MustafaSeyhan/STM32F103-DENEY-KARTI/program kurulum linki.txt

proteus 8.13 program kurulum linki:

https://drive.google.com/drive/folders/1x-LD3BekIUSsy72zg72kJlgUW_x6A9uk?usp=sharing
