MustafaSeyhan/STM32F103-DENEY-KARTI/STM32F103_DENEME_KARTI_2025-2026_2_ŞEMA.png

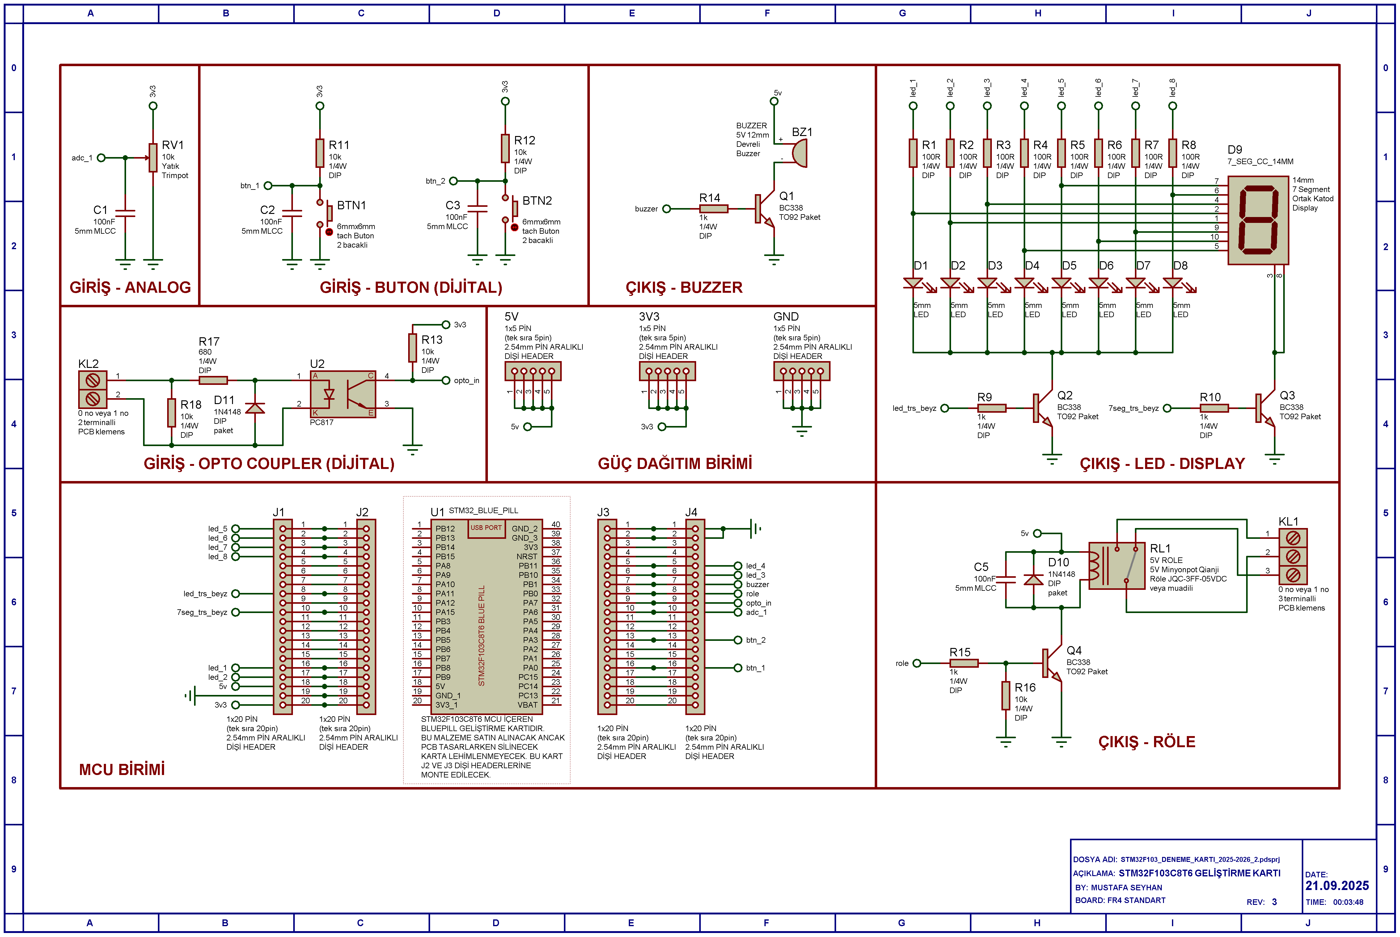
STM32F103_DENEME_KARTI_2025-2026_2_ŞEMA.png
