MustafaSeyhan/STM32F103-DENEY-KARTI/Veri Toplama ve dokümanlar/61TfQhFysAL._AC_SL1200_.jpg

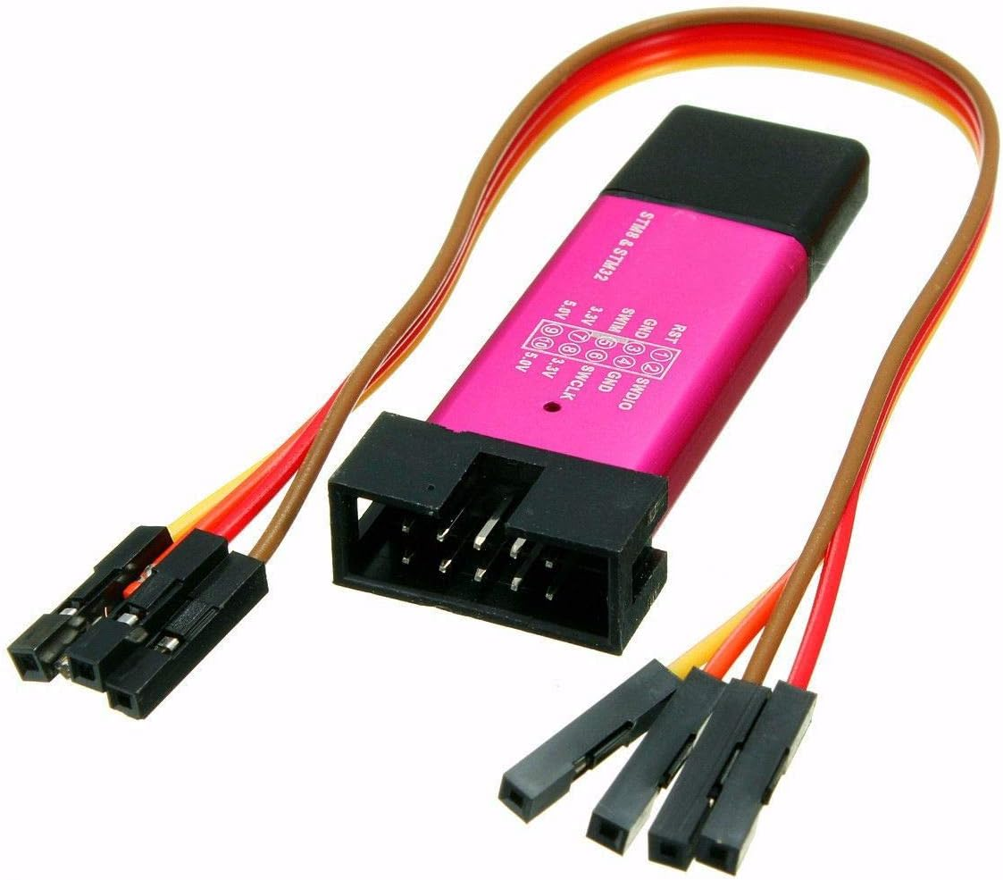
Veri Toplama ve dokümanlar/61TfQhFysAL._AC_SL1200_.jpg
