MustafaSeyhan/STM32F103-DENEY-KARTI/Veri Toplama ve dokümanlar/klon stlink v2 - 2.png

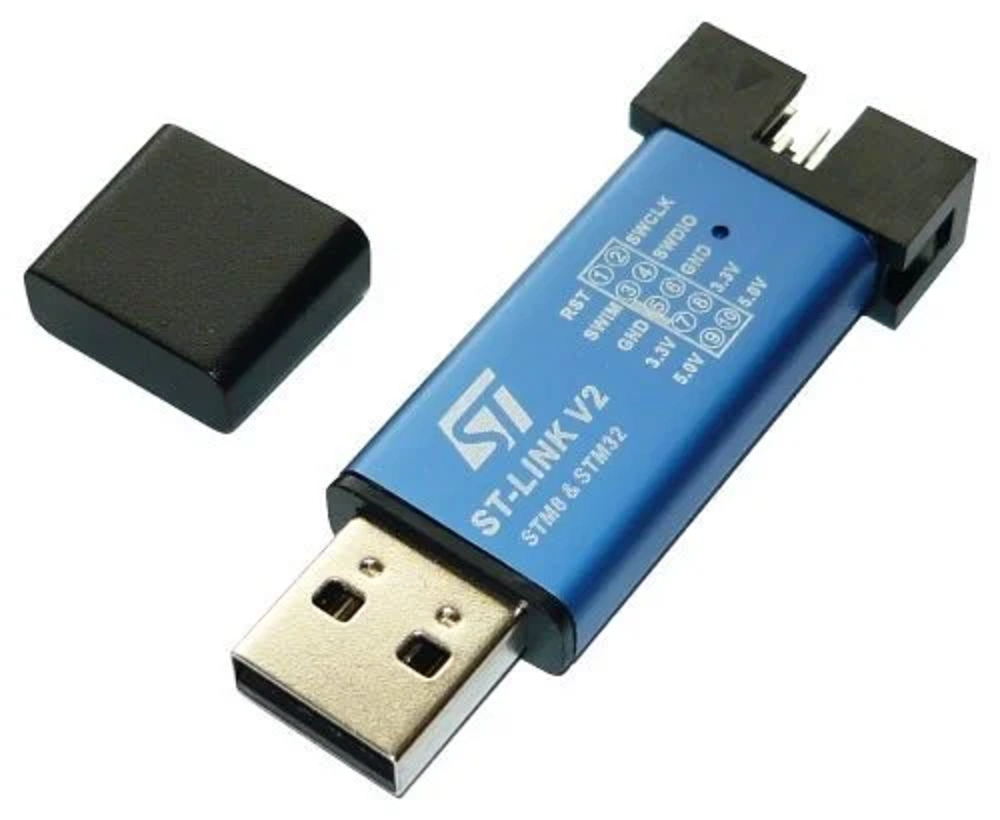
Veri Toplama ve dokümanlar/klon stlink v2 - 2.png
