MustafaSeyhan/STM32F103-DENEY-KARTI/Veri Toplama ve dokümanlar/Stlink v2 Bluepill bağlantısı.png

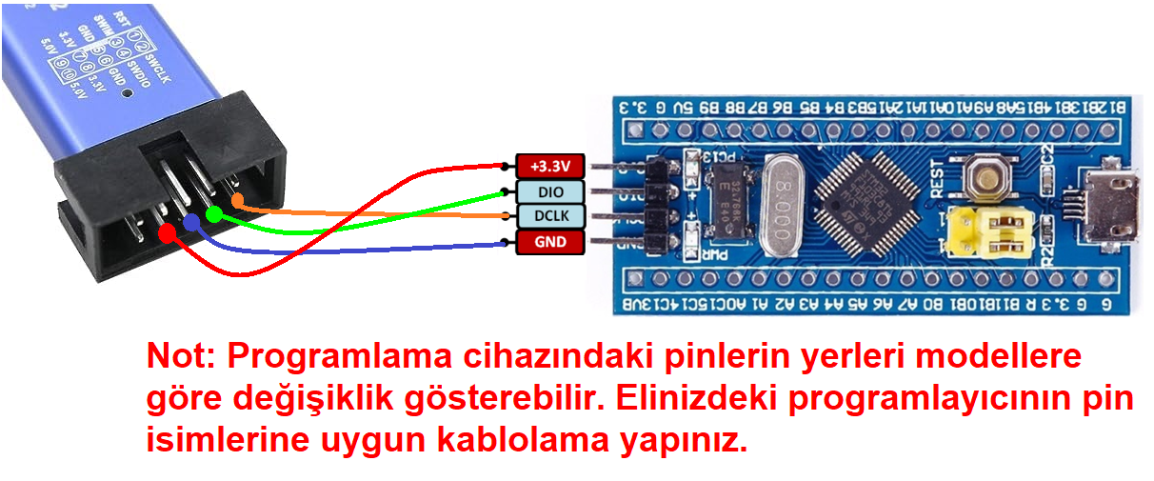
Veri Toplama ve dokümanlar/Stlink v2 Bluepill bağlantısı.png
