MustafaSeyhan/STM32F103-DENEY-KARTI/ARES 3D STEP dosyaları/buzzer_12mm.STEP

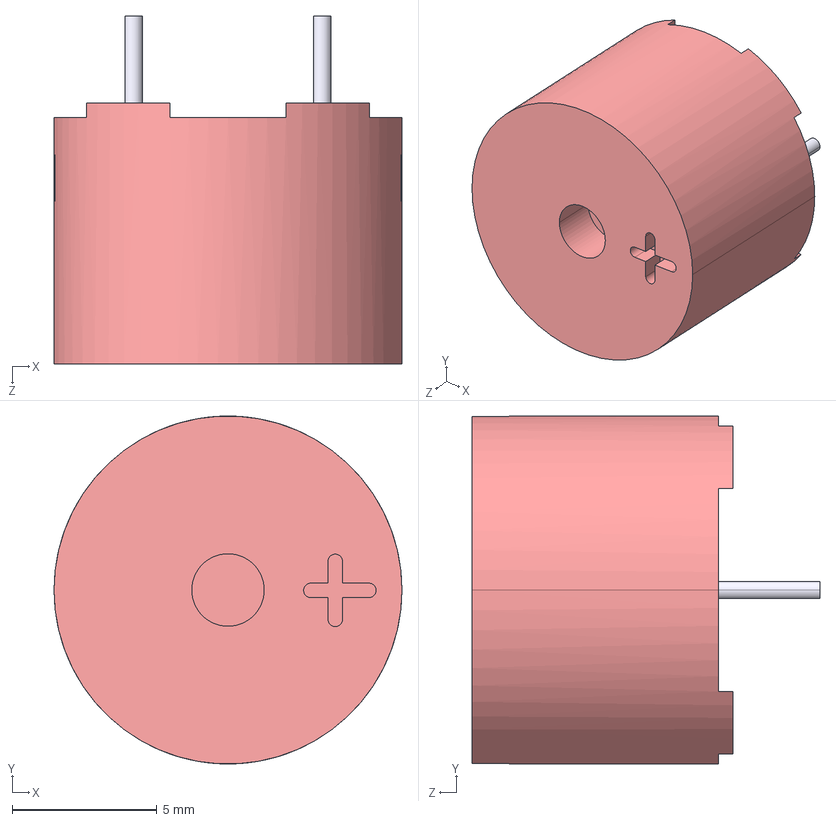
[picture p32: CAD file, 2025-10-20]
ARES 3D STEP dosyaları/buzzer_12mm.STEP
12.0 x 12.0 x 12.0 mm
Imported
Imported_2
Imported_3
