MustafaSeyhan/STM32F103-DENEY-KARTI/ARES 3D STEP dosyaları/7_segment_cc_14mm.step

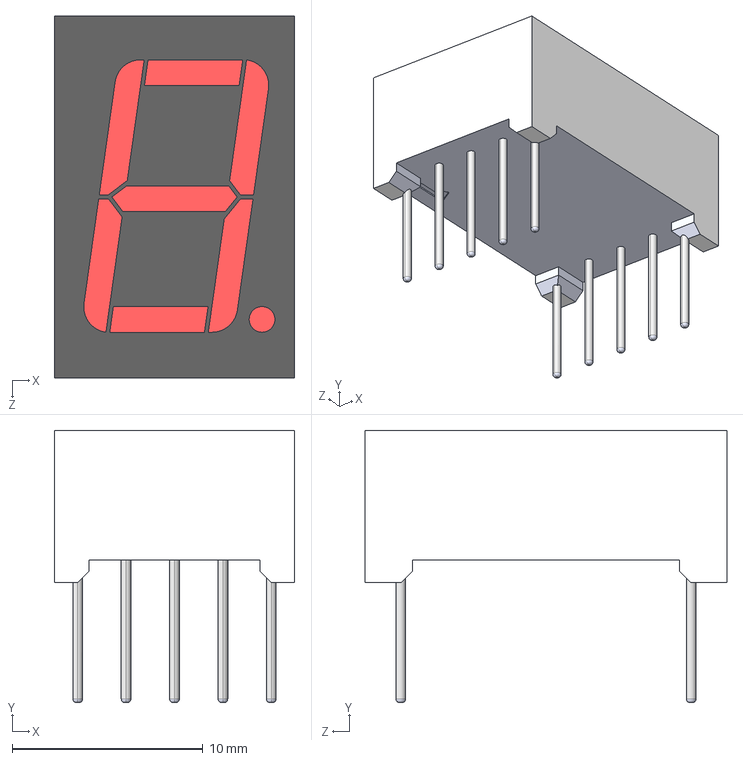
[picture p33: CAD file, 2025-10-20]
ARES 3D STEP dosyaları/7_segment_cc_14mm.step
12.6 x 14.3 x 19.0 mm
