MustafaSeyhan/STM32F103-DENEY-KARTI/ARES 3D STEP dosyaları/20-Pin Header - Female - 2.54mm.step

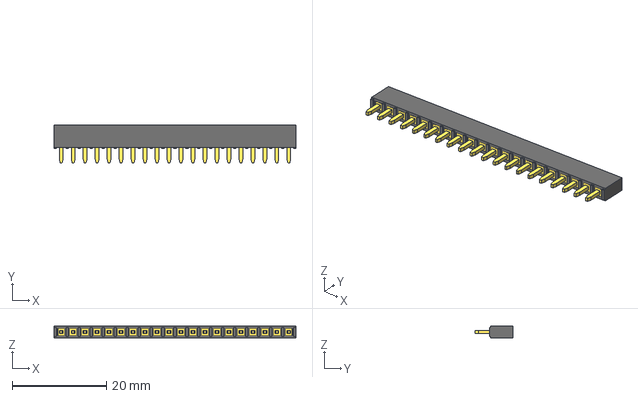
[picture p34: CAD file, 2025-10-20]
ARES 3D STEP dosyaları/20-Pin Header - Female - 2.54mm.step
51.3 x 8.00 x 2.50 mm
