MustafaSeyhan/STM32F103-DENEY-KARTI/ARES 3D STEP dosyaları/trimpot_kare.STEP

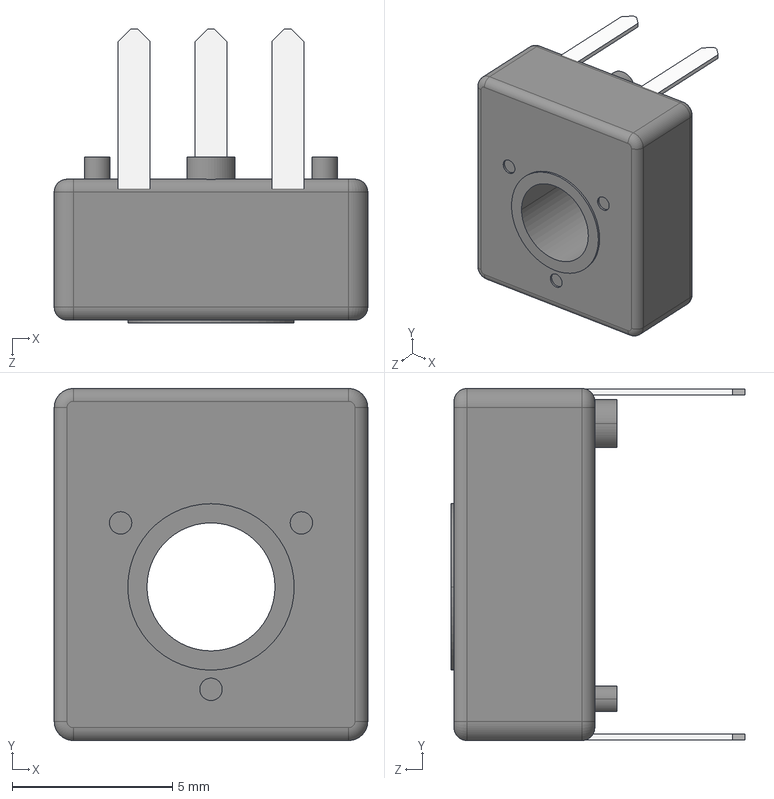
[picture p35: CAD file, 2025-10-20]
ARES 3D STEP dosyaları/trimpot_kare.STEP
9.80 x 11.0 x 9.20 mm
