MustafaSeyhan/STM32F103-DENEY-KARTI/ARES 3D STEP dosyaları/6x6 6mm Tach Buton (4 arm).STEP

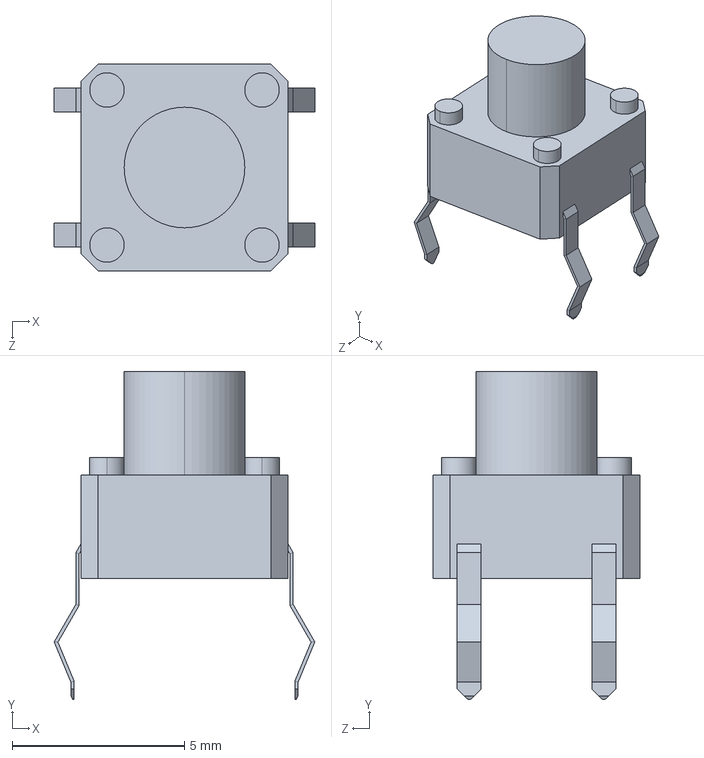
[picture p36: CAD file, 2025-10-20]
ARES 3D STEP dosyaları/6x6 6mm Tach Buton (4 arm).STEP
7.57 x 9.52 x 6.01 mm
