MustafaSeyhan/STM32F103-DENEY-KARTI/ARES 3D STEP dosyaları/KLEMMX2.STEP

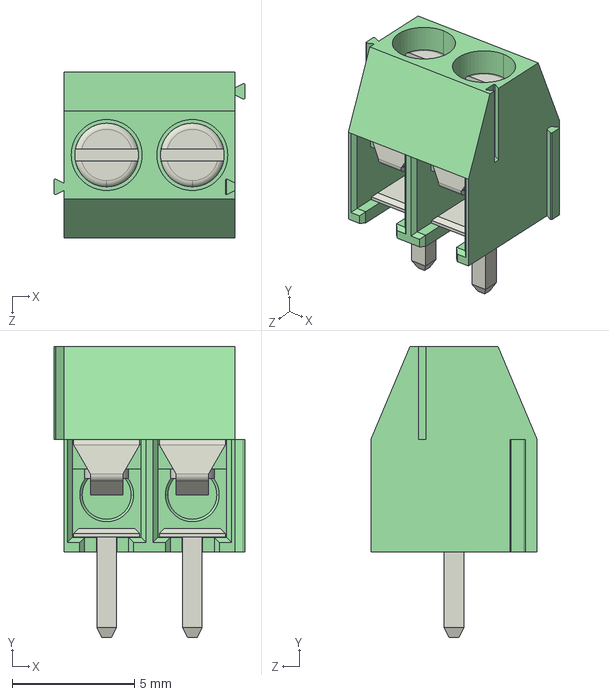
[picture p37: CAD file, 2025-10-20]
ARES 3D STEP dosyaları/KLEMMX2.STEP
7.80 x 11.9 x 6.80 mm
