MustafaSeyhan/STM32F103-DENEY-KARTI/ARES 3D STEP dosyaları/5MM LED RED.step

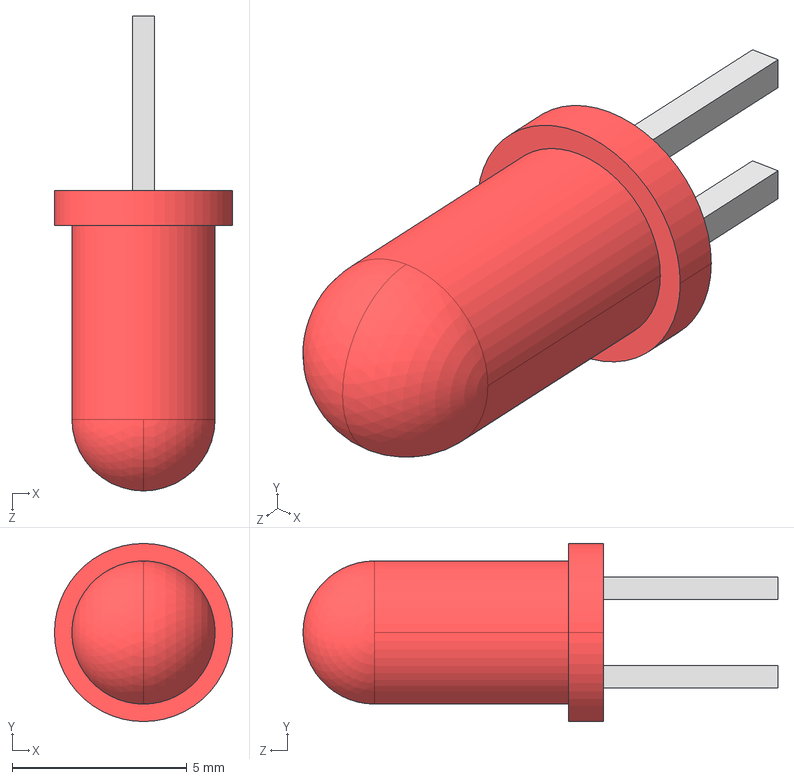
[picture p38: CAD file, 2025-10-20]
ARES 3D STEP dosyaları/5MM LED RED.step
5.10 x 5.10 x 13.6 mm
