MustafaSeyhan/STM32F103-DENEY-KARTI/ARES 3D STEP dosyaları/trimpot_yuvarlak.step

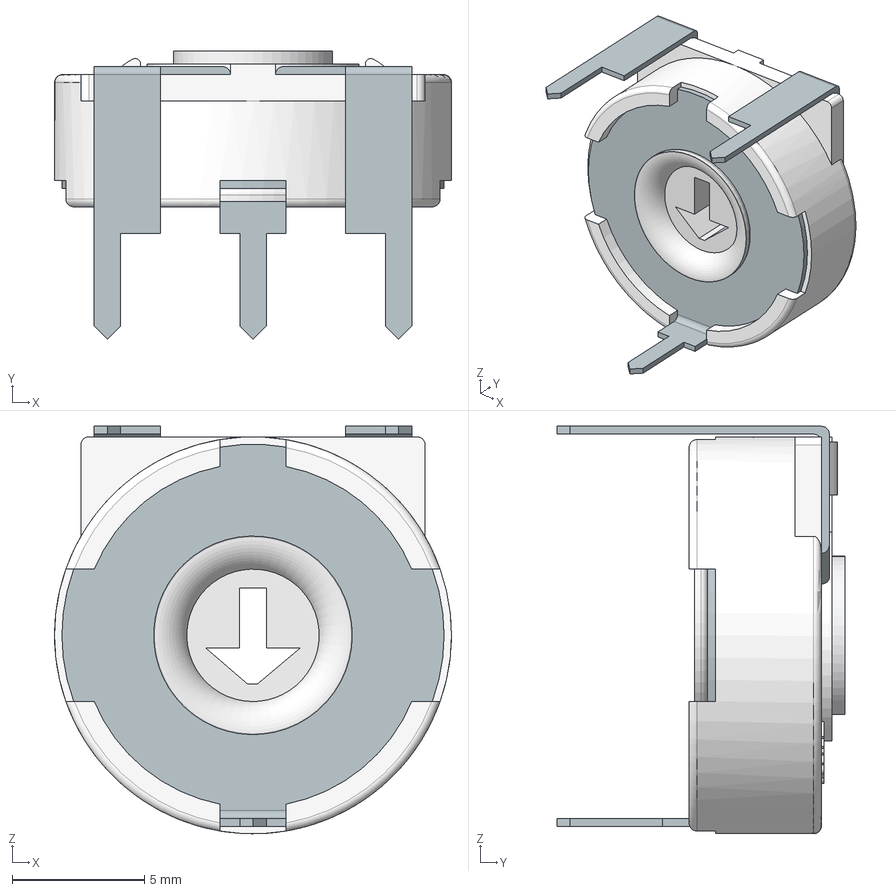
[picture p39: CAD file, 2025-10-20]
ARES 3D STEP dosyaları/trimpot_yuvarlak.step
15.0 x 10.9 x 15.4 mm
Corps_PT-15
Axe
Broche 1
