MustafaSeyhan/STM32F103-DENEY-KARTI/ARES 3D STEP dosyaları/5-Pin Header - Male - 2.54mm.step

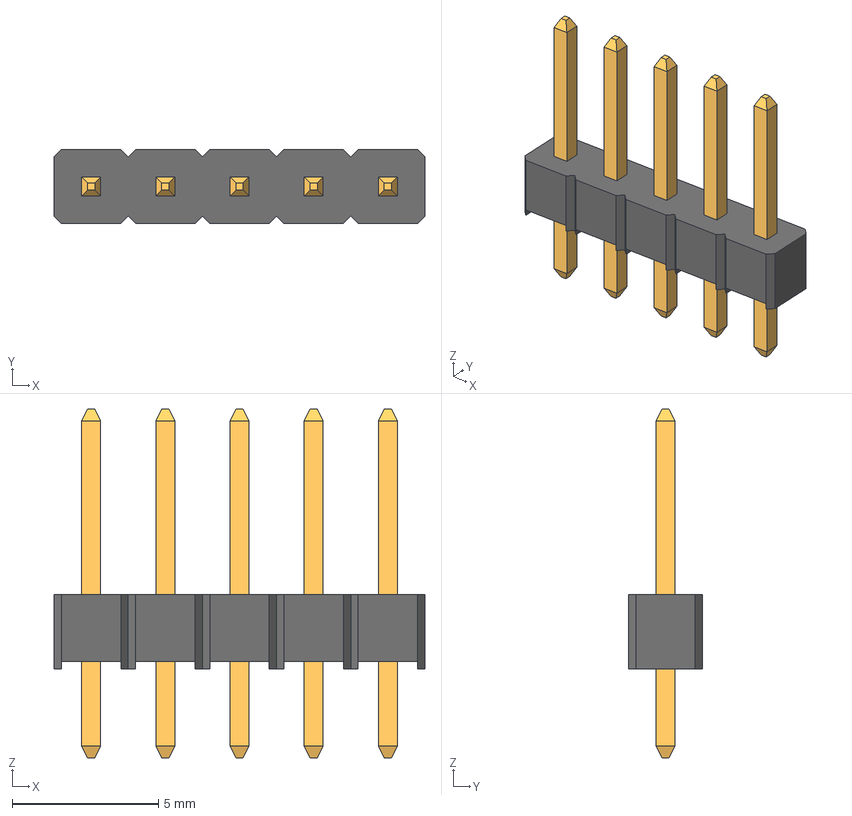
[picture p40: CAD file, 2025-10-20]
ARES 3D STEP dosyaları/5-Pin Header - Male - 2.54mm.step
12.7 x 2.54 x 11.9 mm
