MustafaSeyhan/STM32F103-DENEY-KARTI/ARES 3D STEP dosyaları/KLEMMX3.step

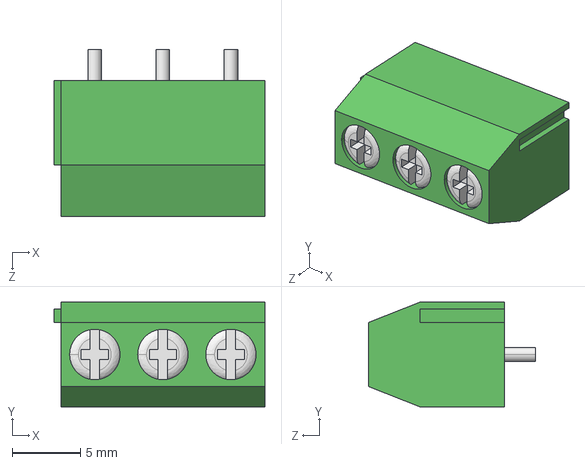
[picture p41: CAD file, 2025-10-20]
ARES 3D STEP dosyaları/KLEMMX3.step
15.5 x 7.70 x 12.3 mm
