MustafaSeyhan/STM32F103-DENEY-KARTI/ARES 3D STEP dosyaları/1 - 3d_model_tanitimi_1.png

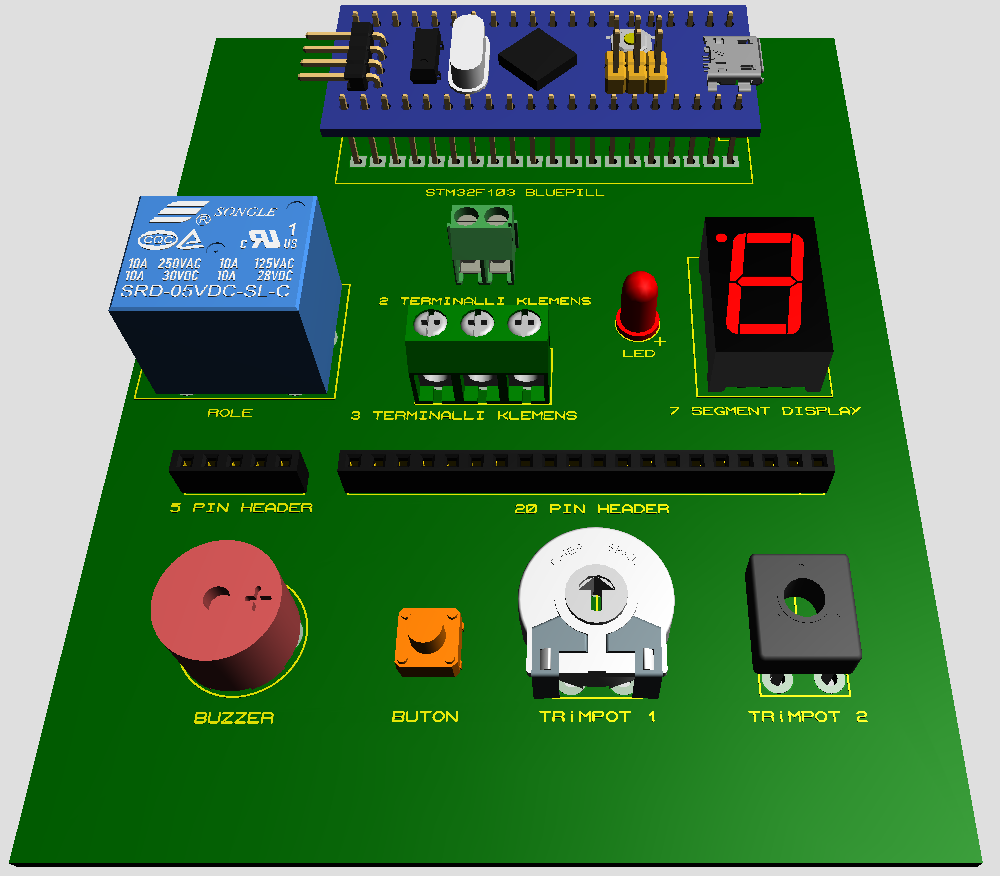
ARES 3D STEP dosyaları/1 - 3d_model_tanitimi_1.png
