MustafaSeyhan/STM32F103-DENEY-KARTI/ARES 3D STEP dosyaları/2 - 3d_model_tanitimi_2.png

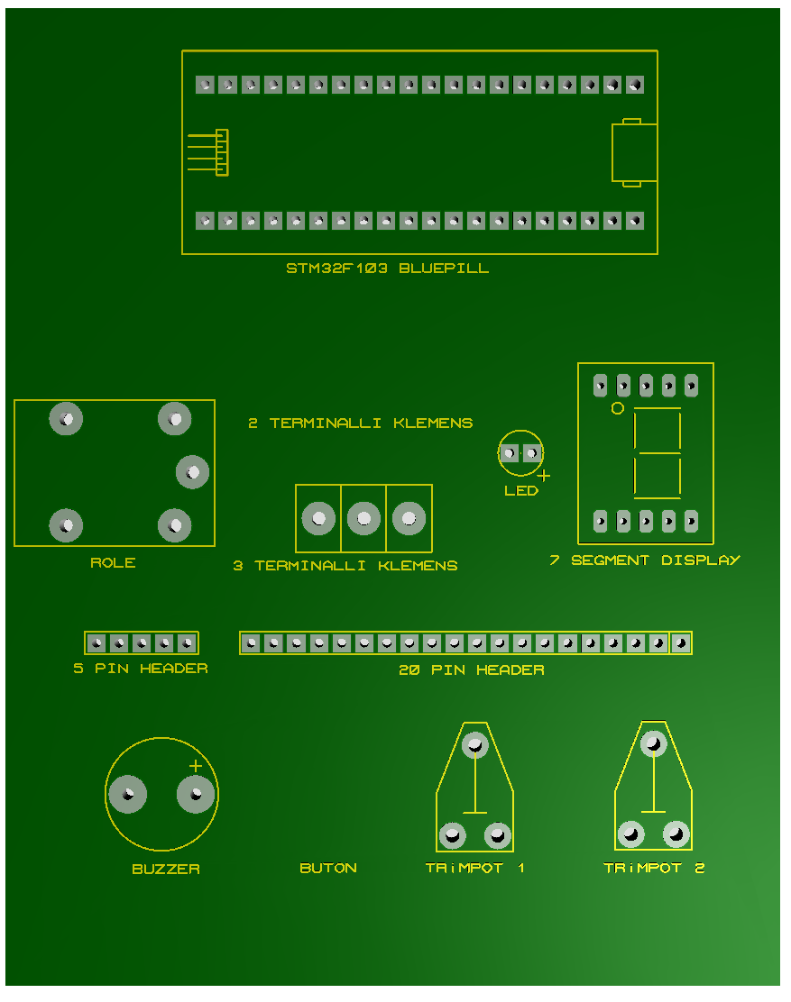
ARES 3D STEP dosyaları/2 - 3d_model_tanitimi_2.png
