MustafaSeyhan/STM32F103-DENEY-KARTI/STM32F103_DENEME_KARTI_2025-2026_2_ŞEMA.pdf

D9

R1

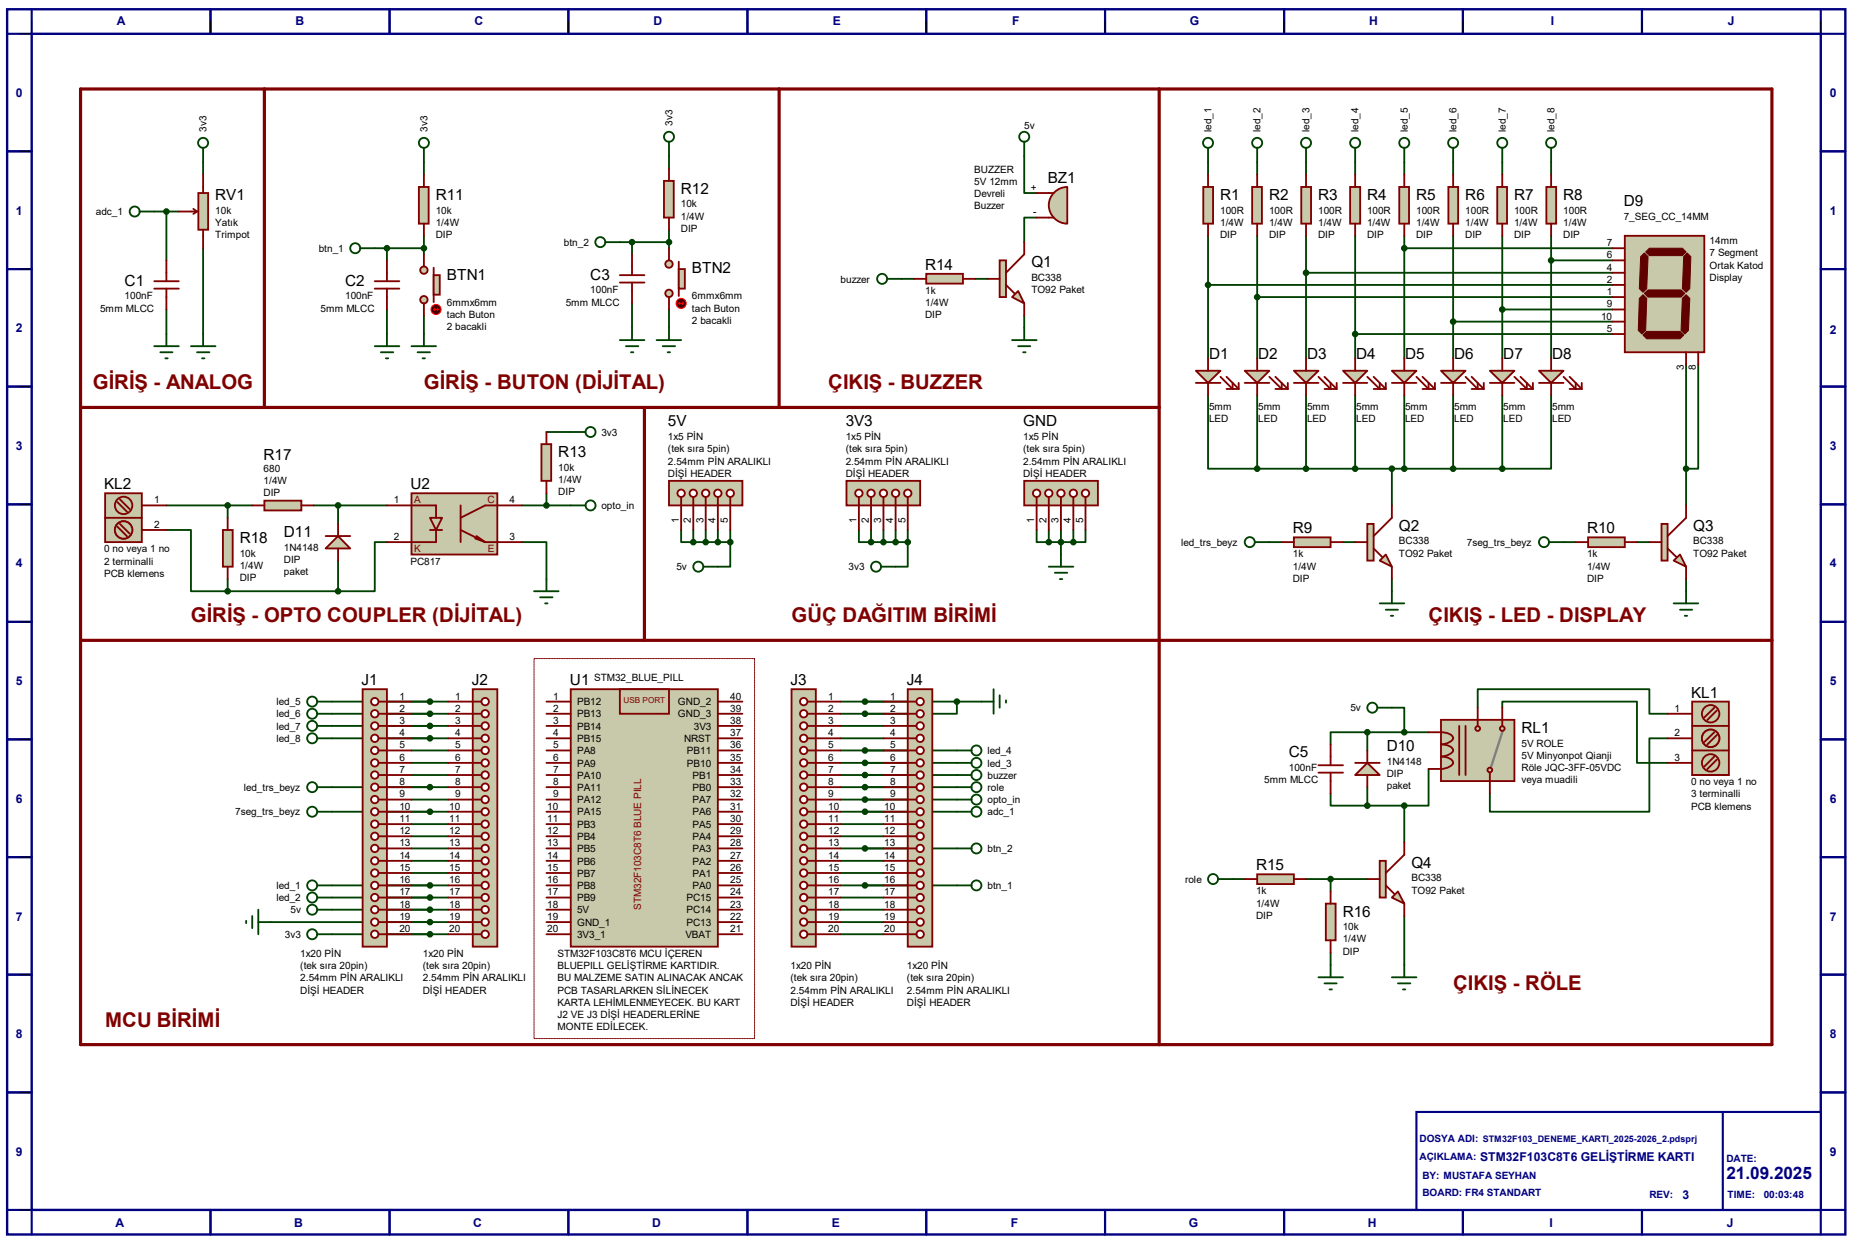
[picture p45: page 1]

DİŞİ HEADER STM³²F103C⁸T6 BLUE PILL

STM32F103C8T6 MCU İÇEREN
BLUEPILL GELİŞTİRME KARTIDIR.
BU MALZEME SATIN ALINACAK ANCAK
PCB TASARLARKEN SİLİNECEK
KARTA LEHİMLENMEYECEK. BU KART
J2 VE J3 DİŞİ HEADERLERİNE
MONTE EDİLECEK.
