MustafaSeyhan/STM32F103-DENEY-KARTI/kart_test_5/Core/Src/main.c

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
/* Includes ------------------------------------------------------------------*/
#include "main.h"
#include <led_display_role_buzzer_test.h>
#include <buton_test.h>
#include <yedisegment_ekran_yazdirma.h>
#include <adc_test.h>
ADC_HandleTypeDef hadc1;

/* USER CODE BEGIN PV */
uint16_t sayac=0;
/* USER CODE END PV */

void SystemClock_Config(void);
static void MX_GPIO_Init(void);
static void MX_ADC1_Init(void);
/**
  * @brief  The application entry point.
  * @retval int
  */
int main(void)
{
  /* MCU Configuration--------------------------------------------------------*/

  /* Reset of all peripherals, Initializes the Flash interface and the Systick. */
  HAL_Init();

  /* Configure the system clock */
  SystemClock_Config();

  /* Initialize all configured peripherals */
  MX_GPIO_Init();
  MX_ADC1_Init();
  /* USER CODE BEGIN 2 */
  HAL_GPIO_WritePin(trs_yedi_segment_GPIO_Port, trs_led_Pin, GPIO_PIN_SET);
  //HAL_GPIO_WritePin(trs_buzzer_GPIO_Port, trs_buzzer_Pin, GPIO_PIN_SET);
  /* USER CODE END 2 */

  /* Infinite loop */
  /* USER CODE BEGIN WHILE */
  while (1)
  {
    /* USER CODE END WHILE */

    /* USER CODE BEGIN 3 */
	role_testi();
	buzzer_testi();
	led_display_testi();
	buton_test();

	for(sayac=0;sayac<10;sayac++)
	{

		yedi_segment_yazdir(sayac);
		HAL_Delay(750);
	}

	adc_test();

  }
  /* USER CODE END 3 */
}

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
