MustafaSeyhan/STM32F103-DENEY-KARTI/kart_test_5/Core/Inc/main.h

#define led_builtin_Pin GPIO_PIN_13
#define led_builtin_GPIO_Port GPIOC
#define buton_1_Pin GPIO_PIN_0
#define buton_1_GPIO_Port GPIOA
#define buton_2_Pin GPIO_PIN_3
#define buton_2_GPIO_Port GPIOA
#define buton_3_Pin GPIO_PIN_7
#define buton_3_GPIO_Port GPIOA
#define trs_role_Pin GPIO_PIN_0
#define trs_role_GPIO_Port GPIOB
#define trs_buzzer_Pin GPIO_PIN_1
#define trs_buzzer_GPIO_Port GPIOB
#define led_3_C_Pin GPIO_PIN_10
#define led_3_C_GPIO_Port GPIOB
#define led_4_DP_Pin GPIO_PIN_11
#define led_4_DP_GPIO_Port GPIOB
#define led_5_A_Pin GPIO_PIN_12
#define led_5_A_GPIO_Port GPIOB
#define led_6_G_Pin GPIO_PIN_13
#define led_6_G_GPIO_Port GPIOB
#define led_7_F_Pin GPIO_PIN_14
#define led_7_F_GPIO_Port GPIOB
#define led_8_B_Pin GPIO_PIN_15
#define led_8_B_GPIO_Port GPIOB
#define trs_led_Pin GPIO_PIN_11
#define trs_led_GPIO_Port GPIOA
#define trs_yedi_segment_Pin GPIO_PIN_15
#define trs_yedi_segment_GPIO_Port GPIOA
#define led_1_D_Pin GPIO_PIN_8
#define led_1_D_GPIO_Port GPIOB
#define led_2_E_Pin GPIO_PIN_9
#define led_2_E_GPIO_Port GPIOB
