MustafaSeyhan/STM32F103-DENEY-KARTI/kart_test_5/Core/Inc/led_display_role_buzzer_test.h

/*
 * led_display_test.h
 *
 *  Created on: Jan 16, 2025
 *      Author: Mustafa
 */

#ifndef INC_LED_DISPLAY_ROLE_BUZZER_TEST_H_
#define INC_LED_DISPLAY_ROLE_BUZZER_TEST_H_


	void led_display_testi();
	void role_testi();
	void buzzer_testi();



#endif /* INC_LED_DISPLAY_ROLE_BUZZER_TEST_H_ */
