MustafaSeyhan/STM32F103-DENEY-KARTI/kart_test_5/Core/Inc/yedisegment_ekran_yazdirma.h

/*
 * yedisegment_ekran_yazdirma.h
 *
 *  Created on: Jan 16, 2025
 *      Author: Mustafa
 */

#ifndef INC_YEDISEGMENT_EKRAN_YAZDIRMA_H_
#define INC_YEDISEGMENT_EKRAN_YAZDIRMA_H_

void yedi_segment_yazdir(int);

#endif /* INC_YEDISEGMENT_EKRAN_YAZDIRMA_H_ */
