MustafaSeyhan/STM32F103-DENEY-KARTI/(commit log)

2025-10-12 Create STM32F103 Deney Kartı Proje Tanımlama Dokümanı V1_3.pdf
2025-10-19 Create STM32F103 Deney Kartı Proje Tanımlama Dokümanı Rev2_1.pdf
2025-10-20 yeni dosya yüklemeleri
    [20-Pin Header - Female - 2.54mm.step, 5-Pin Header - Male - 2.54mm.step, 5MM LED RED.step, 6x6 6mm Tach Buton (4 arm).STEP, 7_segment_cc_14mm.step, KLEMMX2.STEP, KLEMMX3.step, STM32F103C8T6_Blue_Pill v6.step]
