MustafaSeyhan/STM32F103-DENEY-KARTI/(notices)

Notices in the files:
kart_test_5/Core/Inc/main.h:
Copyright (c) 2025 STMicroelectronics.
All rights reserved.
This software is licensed under terms that can be found in the LICENSE file
